fanchenhao2206/pedal-counter/bom-1.JPG

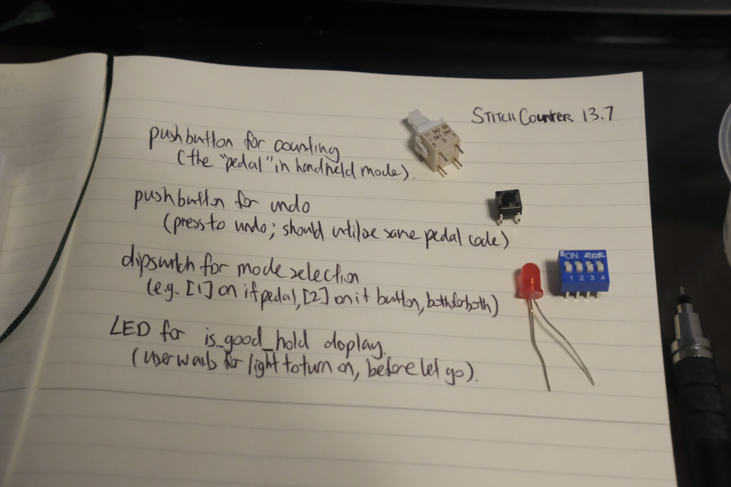
bom-1.JPG
