fanchenhao2206/pedal-counter/pedal-wiring.JPG

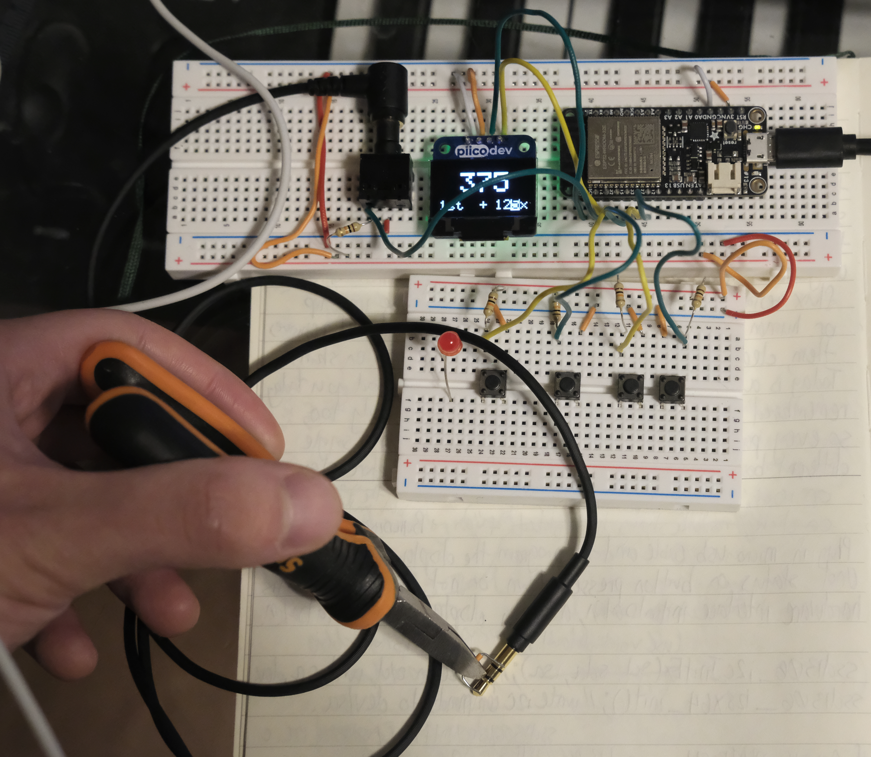
pedal-wiring.JPG
