fanchenhao2206/pedal-counter/1_4.webp

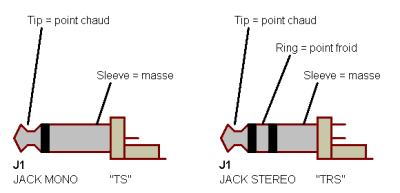
1_4.webp
