fanchenhao2206/pedal-counter/3.5mm.jpg

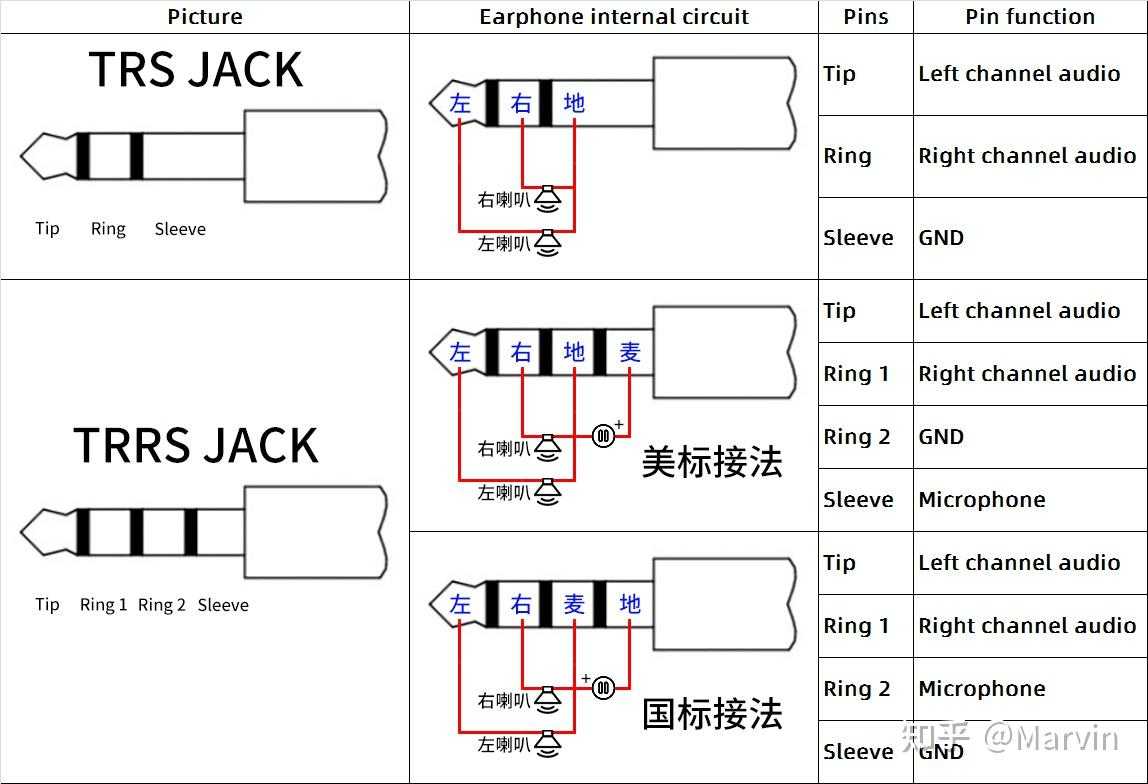
3.5mm.jpg
