fanchenhao2206/pedal-counter/silkscreen.jpeg

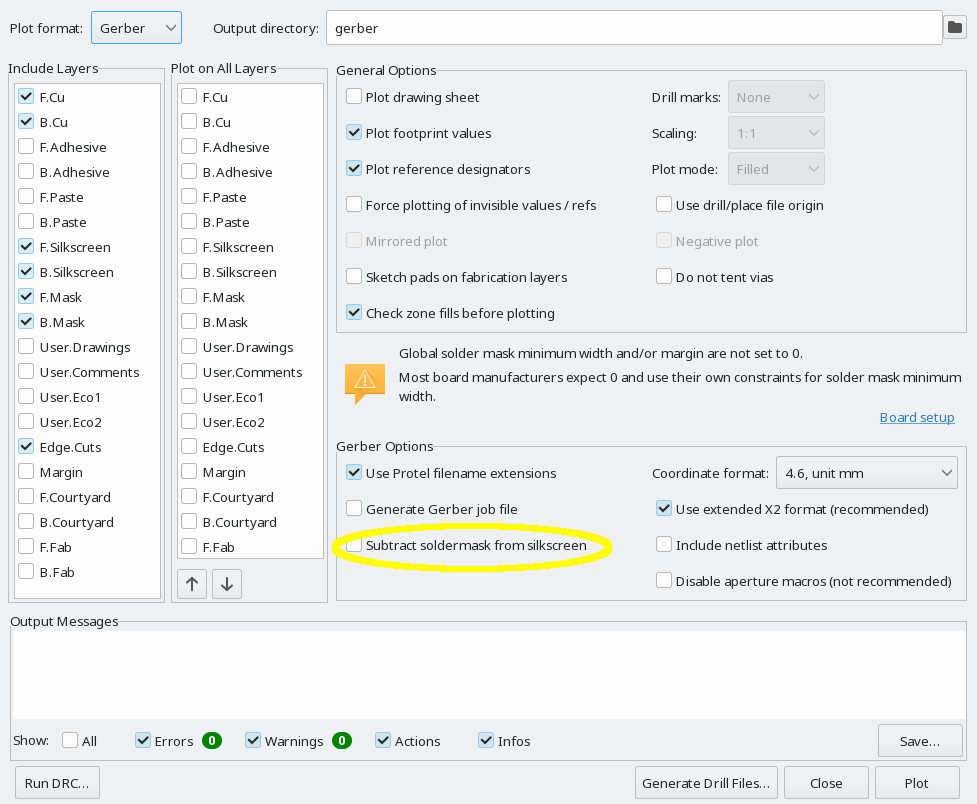
silkscreen.jpeg
