fanchenhao2206/pedal-counter/piico.dev:p14.pdf

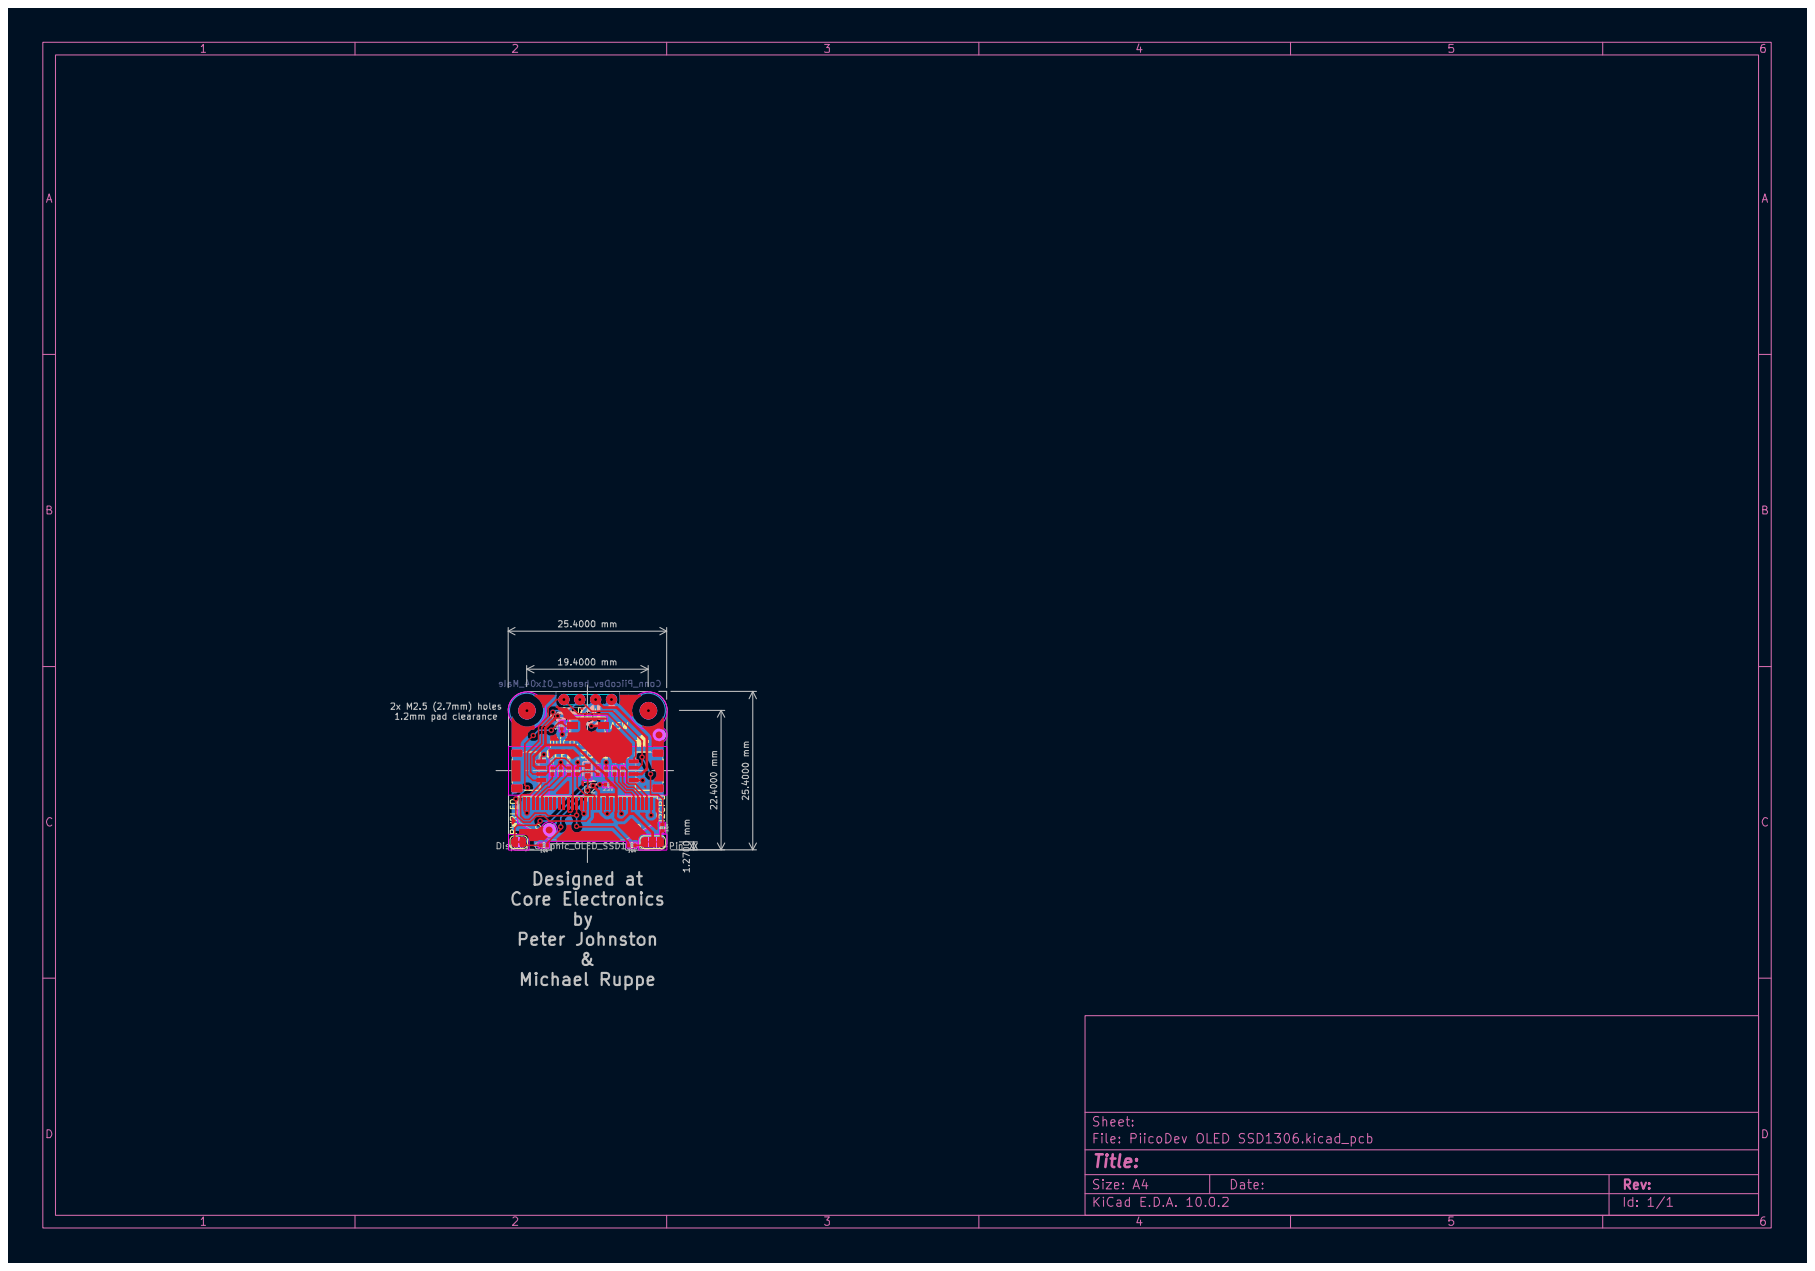
[picture p6: page 1]
