fanchenhao2206/pedal-counter/STX-3120-5B.pdf

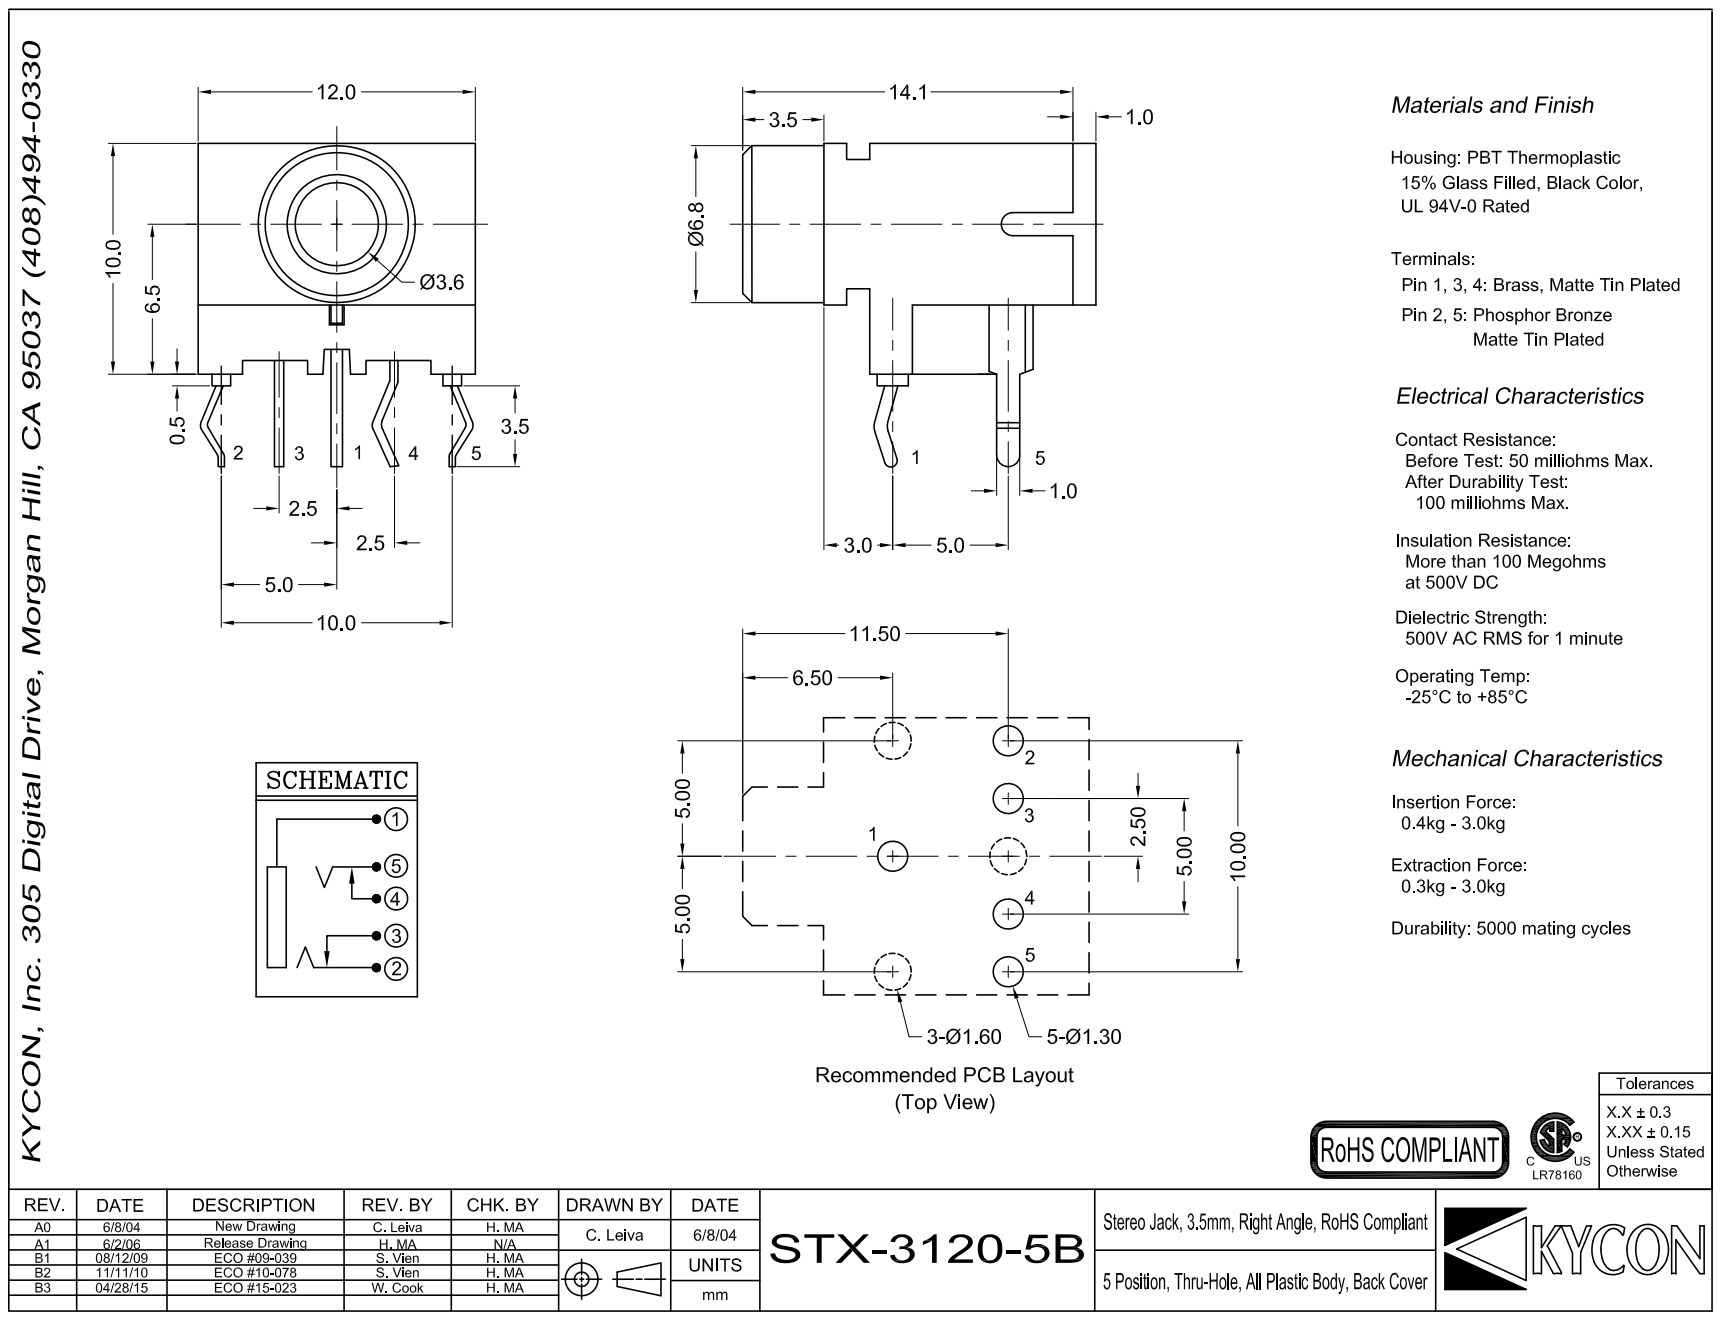
[picture p7: page 1]
