fanchenhao2206/pedal-counter/pcb_safe/pedal_counter.pdf

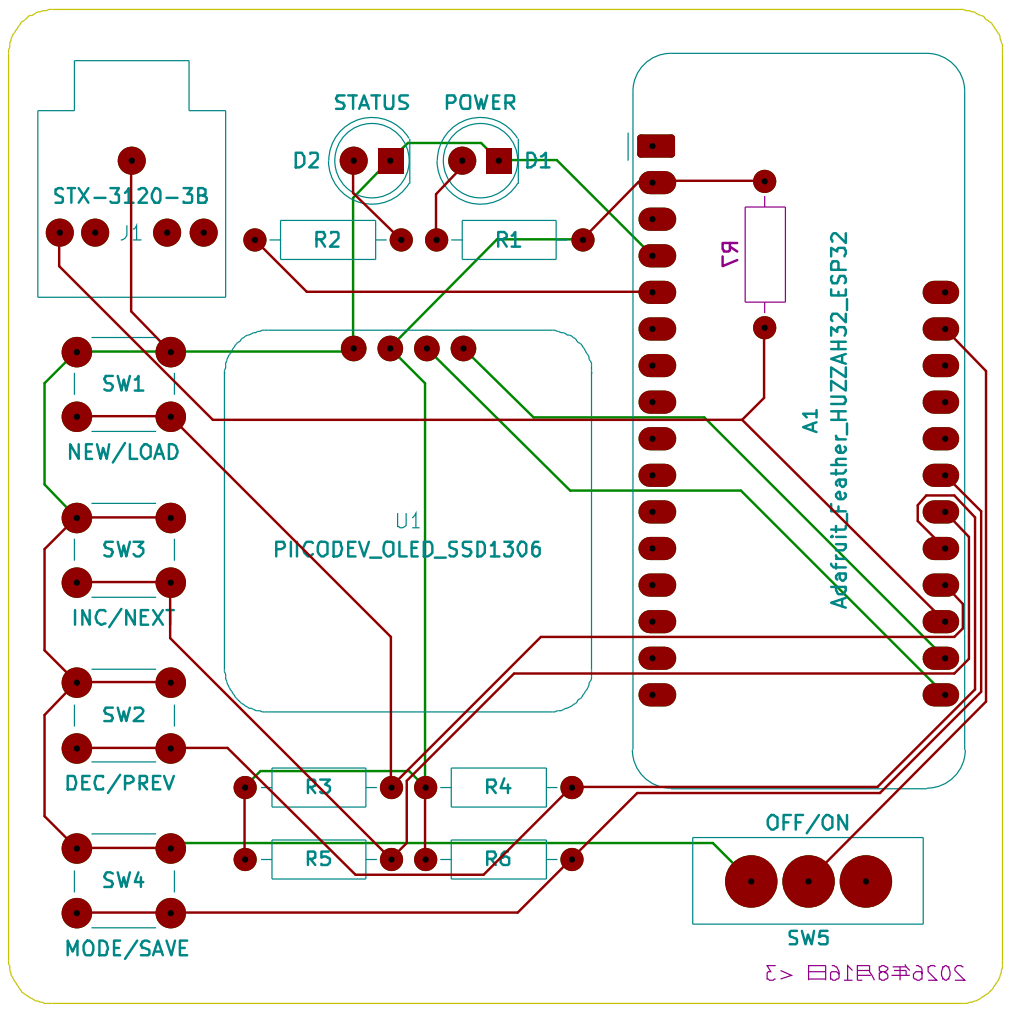
[picture p8: page 1]
