fanchenhao2206/pedal-counter/pcb_compact/pedal_counter.pdf

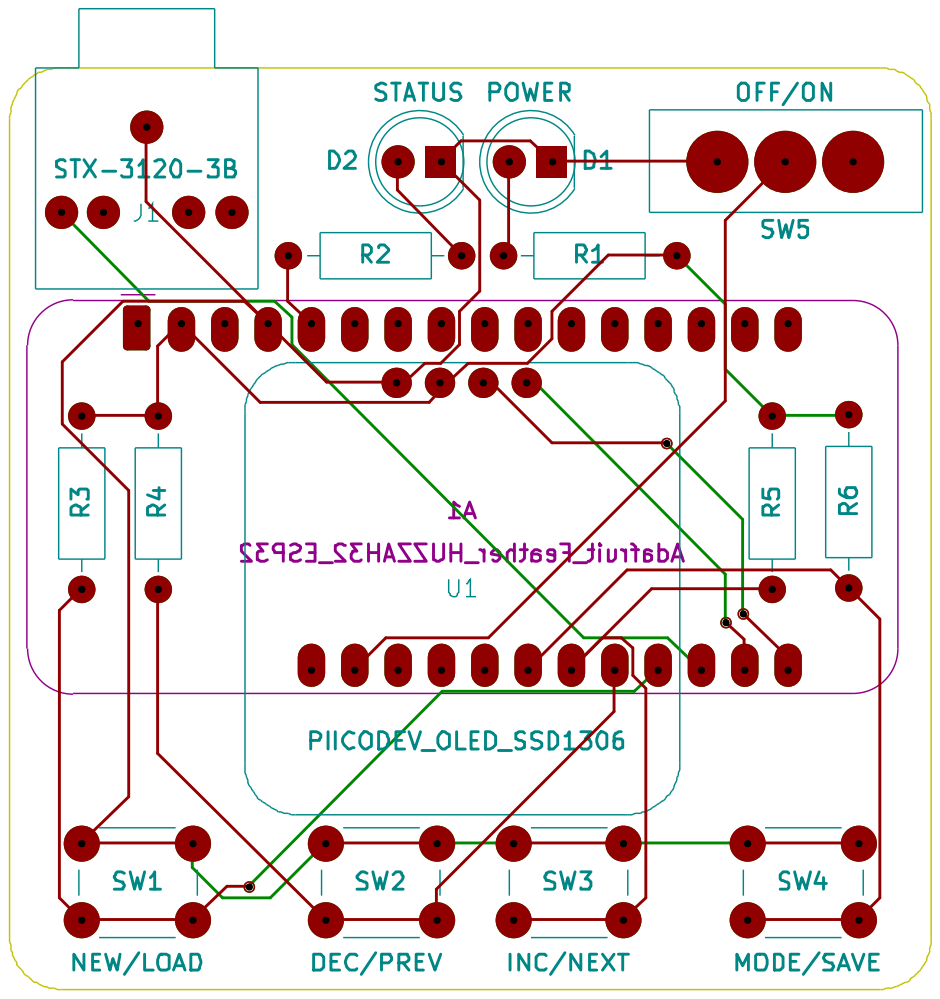
[picture p9: page 1]
