fanchenhao2206/pedal-counter/pcb_safe/pedal-counter.kicad_pcb

## KiCad design pcb_safe/pedal-counter.kicad_pcb (2026-09-21)

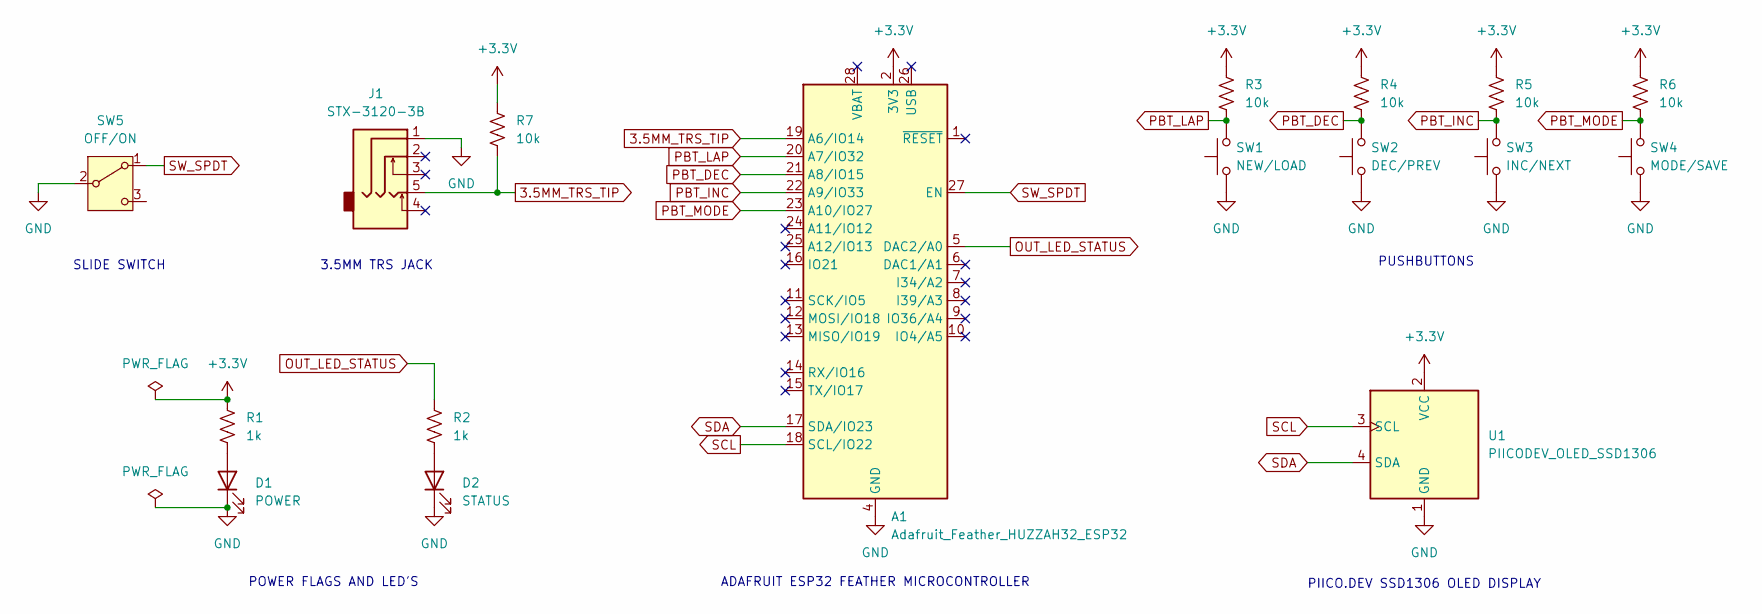
[picture p10: schematic pedal-counter.kicad_sch]

Parts:
A1: Adafruit_Feather_HUZZAH32_ESP32; Adafruit_Feather
D1: POWER; LED_D5.0mm
D2: STATUS; LED_D5.0mm
J1: STX-3120-3B
R1, R2: 1k; R_Axial_DIN0207_L6.3mm_D2.5mm_P10.16mm_Horizontal
R3, R4, R5, R6, R7: 10k; R_Axial_DIN0207_L6.3mm_D2.5mm_P10.16mm_Horizontal
SW1: NEW/LOAD; SW_PUSH_6mm
SW2: DEC/PREV; SW_PUSH_6mm
SW3: INC/NEXT; SW_PUSH_6mm
SW4: MODE/SAVE; SW_PUSH_6mm
SW5: OFF/ON; CUSTOM_SW_SLIDE_SPDT
U1: PIICODEV_OLED_SSD1306

Connections:
3.5MM_TRS_TIP: A1.19 (A6/IO14), J1.5, R7.2
+3.3V: A1.2 (3V3), R1.1, R3.1, R4.1, R5.1, R6.1, R7.1, U1.2 (VCC)
GND: A1.4 (GND), D1.1 (K), D2.1 (K), J1.1, SW1.1, SW2.1, SW3.1, SW4.1, SW5.2 (B), U1.1 (GND)
unnamed: D1.2 (A), R1.2
unnamed: D2.2 (A), R2.2
OUT_LED_STATUS: A1.5 (DAC2/A0), R2.1
PBT_DEC: A1.21 (A8/IO15), R4.2, SW2.2
PBT_INC: A1.22 (A9/IO33), R5.2, SW3.2
PBT_LAP: A1.20 (A7/IO32), R3.2, SW1.2
PBT_MODE: A1.23 (A10/IO27), R6.2, SW4.2
SCL: A1.18 (SCL/IO22), U1.3 (SCL)
SDA: A1.17 (SDA/IO23), U1.4 (SDA)
SW_SPDT: A1.27 (EN), SW5.1 (A)

Notes on the sheet:
POWER FLAGS AND LED'S
ADAFRUIT ESP32 FEATHER MICROCONTROLLER
3.5MM TRS JACK
SLIDE SWITCH
PIICO.DEV SSD1306 OLED DISPLAY
PUSHBUTTONS

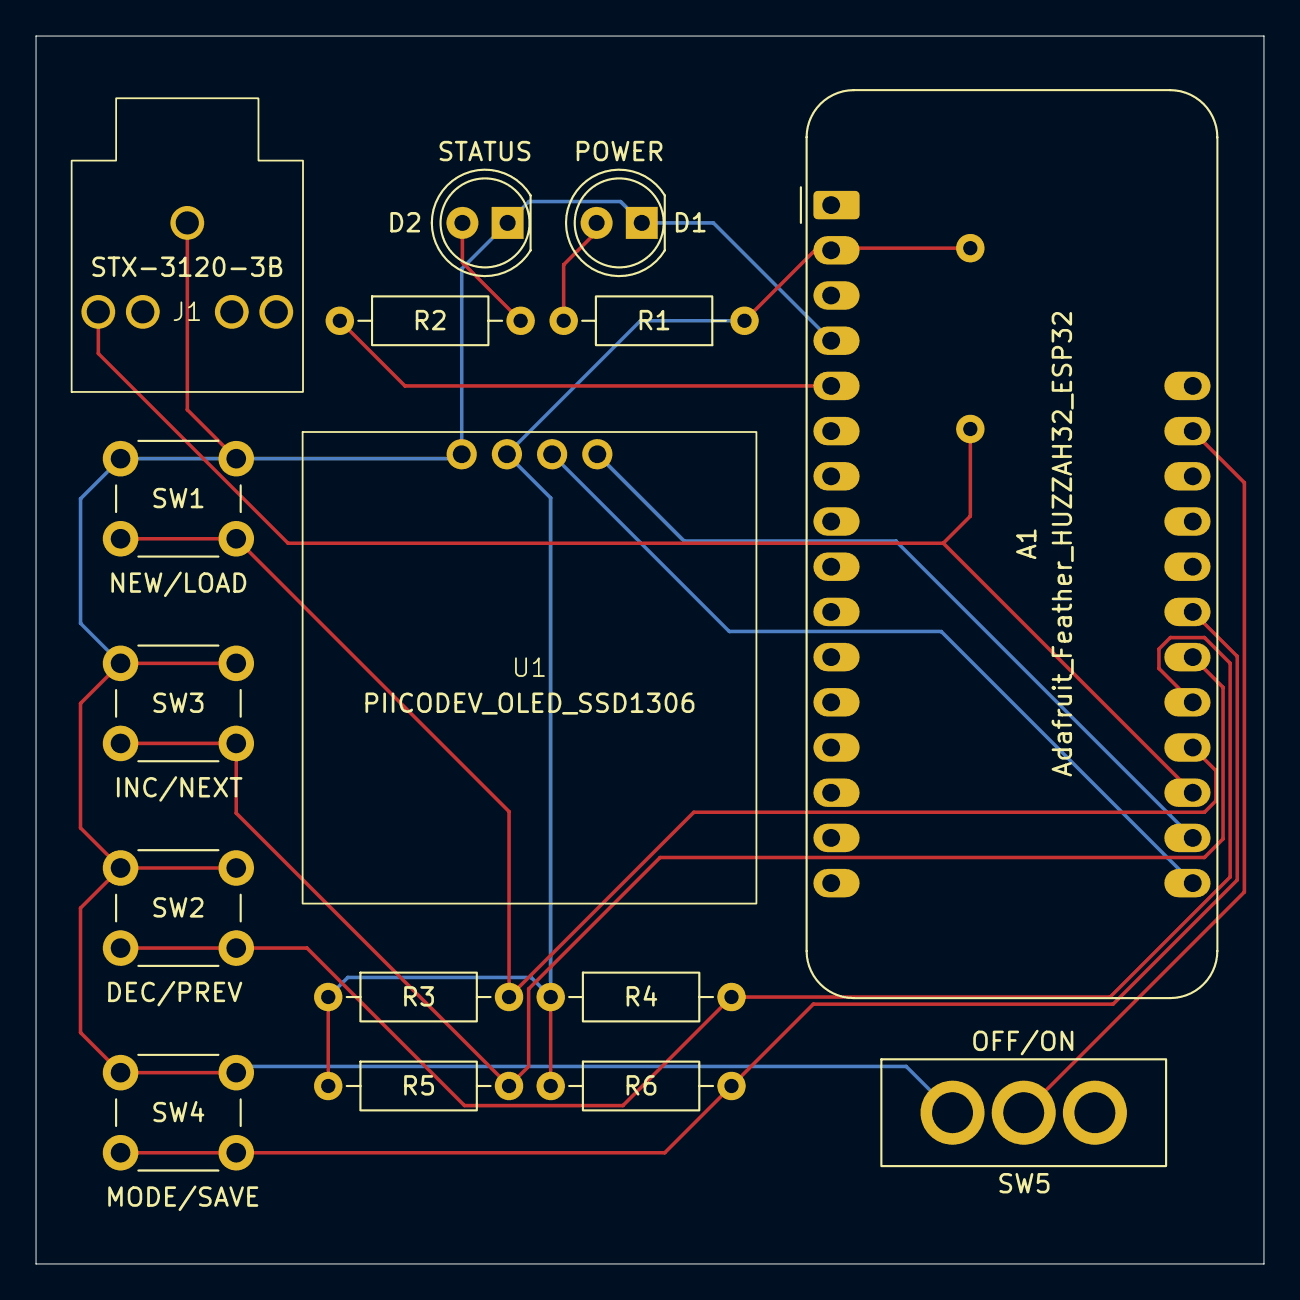
[picture p11: board pedal-counter.kicad_pcb from above]

Board: 2 copper layers, 69.0 x 69.0 mm, 17 parts (1 on the bottom side), 13 nets.
